JKrede/TPI-ED3/doc/img/DdB_ISR_Timer_2.pdf

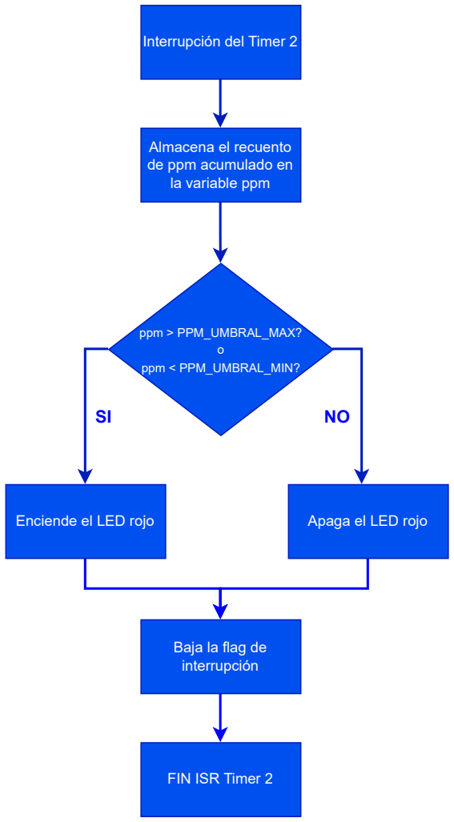
[picture p4: figure]
Interrupción del Timer 2; Almacena el recuento de ppm acumulado en la variable ppm; ppm > PPM_UMBRAL_MAX? o ppm < PPM_UMBRAL_MIN?; Enciende el LED rojo; Apaga el LED rojo; Baja la flag de interrupción; FIN ISR Timer 2
