JKrede/TPI-ED3/doc/img/DdB_Prog_princ.pdf

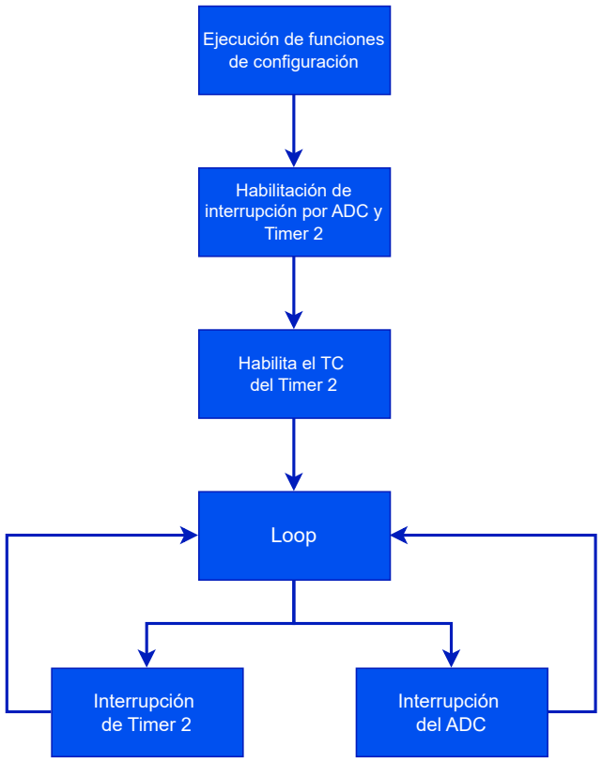
[picture p5: figure]
Ejecución de funciones de configuración; Habilitación de interrupción por ADC y Timer 2; Habilita el TC del Timer 2; Loop; Interrupción del ADC; Interrupción de Timer 2
