JKrede/TPI-ED3/doc/img/Diagrama-de-bloques.pdf

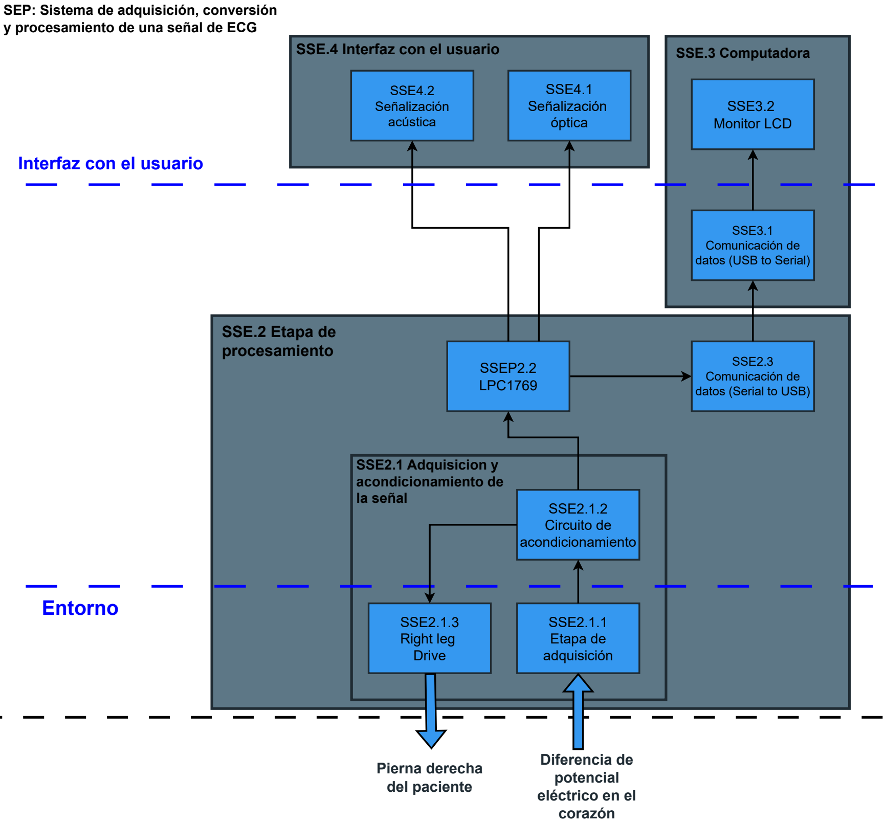
[picture p6: figure]
SSE.2 Etapa de procesamiento; SSE4.1 Señalización óptica; SSE4.2 Señalización acústica; SSE3.2 Monitor LCD; SSE2.3 Comunicación de datos (Serial to USB); SSEP2.2 LPC1769; SSE3.1 Comunicación de datos (USB to Serial); SSE.4 Interfaz con el usuario; SSE.3 Computadora; SEP: Sistema de adquisición, conversión y procesamiento de una señal de ECG; Interfaz con el usuario; Entorno; Diferencia de potencial eléctrico en el corazón; SSE2.1.2 Circuito de acondicionamiento; SSE2.1.1 Etapa de adquisición; SSE2.1 Adquisicion y acondicionamiento de la señal; SSE2.1.3 Right leg Drive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
