JKrede/TPI-ED3/doc/img/rld_diagram.png

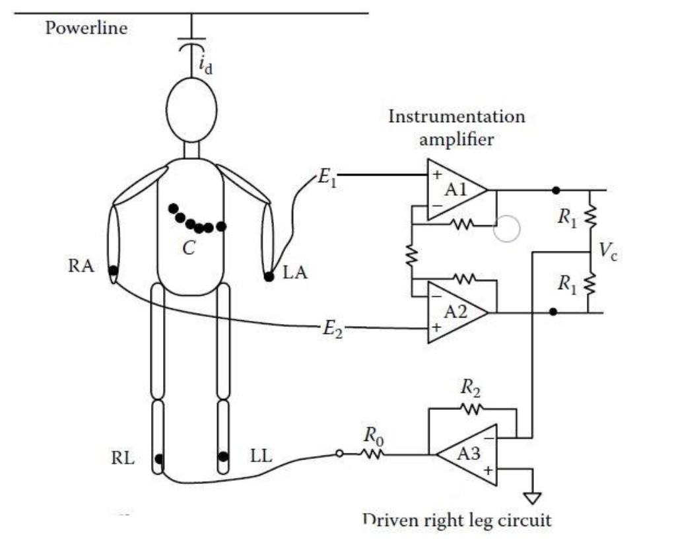
doc/img/rld_diagram.png
