JKrede/TPI-ED3/doc/casos_de_prueba.ods

Nro. de caso de prueba | Descripción del caso de prueba | Pasos | Resultado esperado | Resultado obtenido | Observaciones
1 | Envío de datos mediante el circuito de comunicación de datos
2 | Envío e interpretación correcta de los datos enviados en la aplicación desarrollada en la PC
3 | Activación del sistema de señalización óptica
4
5
4 | Activación del sistema de señalización acústica
