JKrede/TPI-ED3/doc/img/codigo_config.pdf

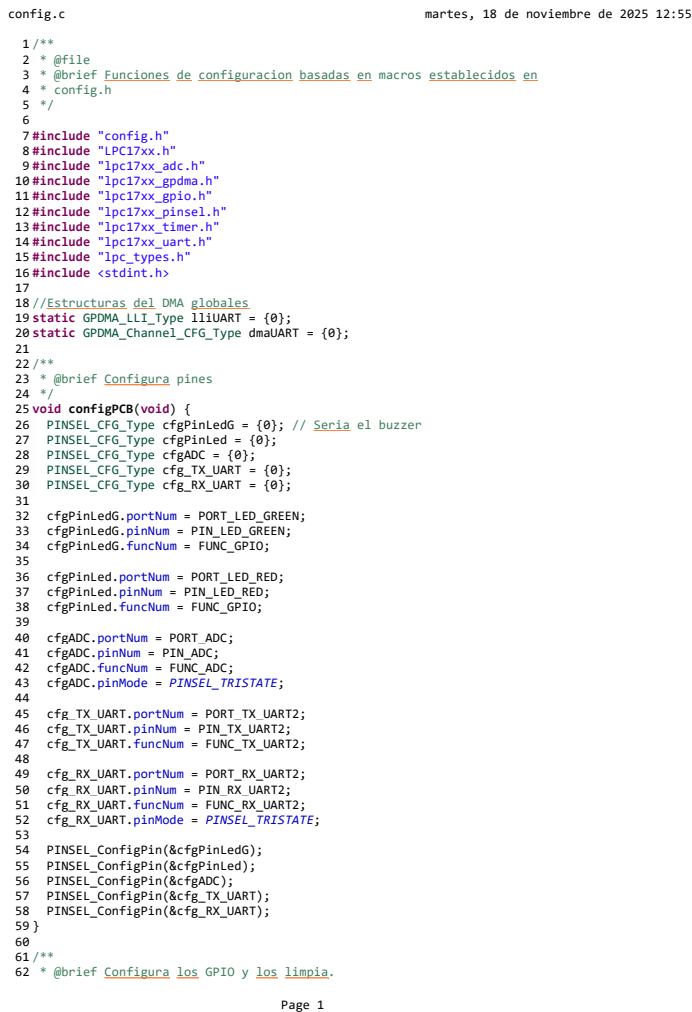
[picture p40: page 1]
config.c; martes, 18 de noviembre de 2025 12:55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

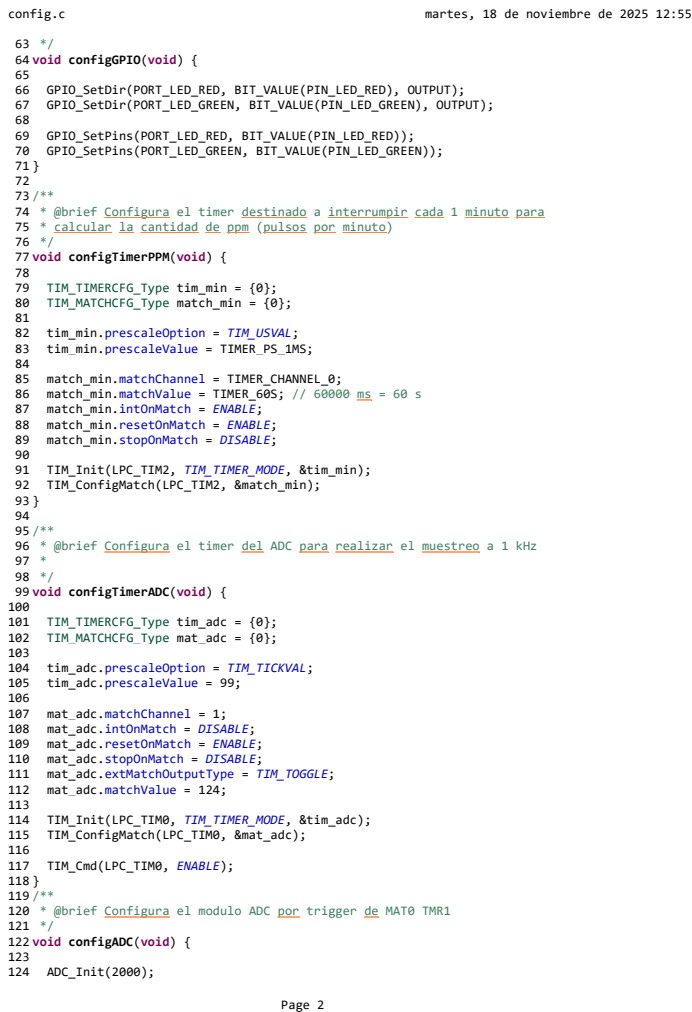
[picture p41: page 2]
config.c; martes, 18 de noviembre de 2025 12:55; 63 */ 64 void configGPIO(void) { 65 66 GPIO_SetDir(PORT_LED_RED, BIT_VALUE(PIN_LED_RED), OUTPUT); 67 GPIO_SetDir(PORT_LED_GREEN, BIT_VALUE(PIN_LED_GREEN), OUTPUT); 68 69 GPIO_SetPins(PORT_LED_RED, BIT_VALUE(PIN_LED_RED)); 70 GPIO_SetPins(PORT_LED_GREEN, BIT_VALUE(PIN_LED_GREEN))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

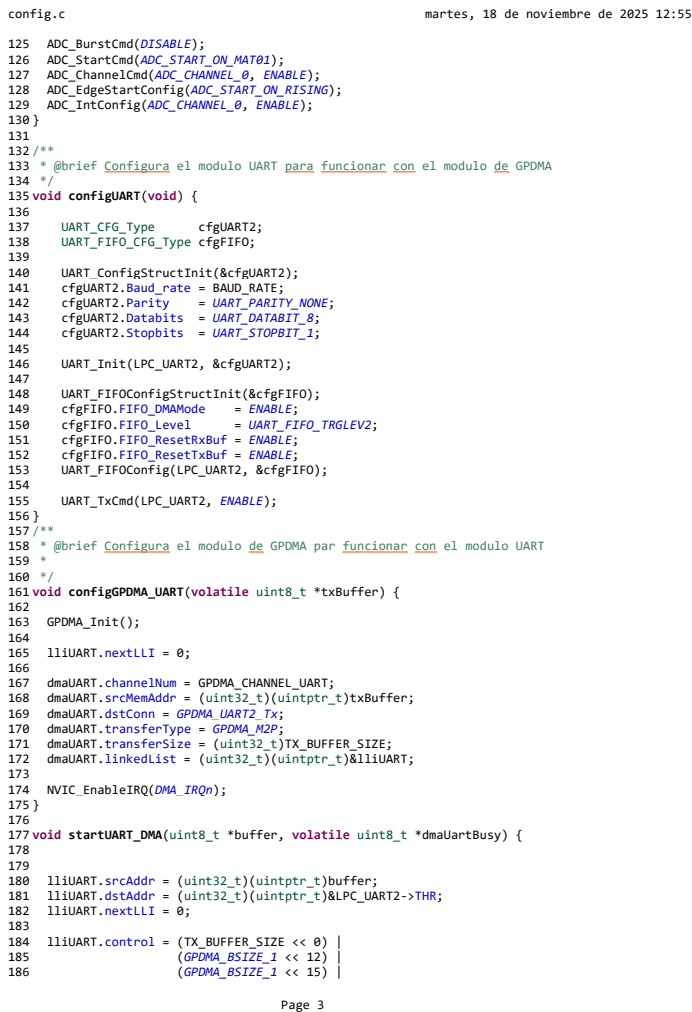
[picture p42: page 3]
config.c; martes, 18 de noviembre de 2025 12:55; 125 ADC_BurstCmd(DISABLE); 126 ADC_StartCmd(ADC_START_ON_MAT01); 127 ADC_ChannelCmd(ADC_CHANNEL_0, ENABLE); 128 ADC_EdgeStartConfig(ADC_START_ON_RISING); 129 ADC_IntConfig(ADC_CHANNEL_0, ENABLE); 130 } 131 132 /** 133 * @brief Configura el modulo UART para funcionar con el modulo de GPDMA 134 */ 135 void configUART(void) { 136; UART_CFG_Type; cfgUART2;; 138 UART_FIFO_CFG_Type cfgFIFO; 139 140 UART_ConfigStructInit(&cfgUART2)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

config.c | martes, 18 de noviembre de 2025 12:55

187 (GPDMA_BYTE << 18) |
188 (GPDMA_BYTE << 21) |
189 (1 << 26) |
190 (0 << 27) |
191 (1 << 31);
192
193 dmaUART.srcMemAddr = (uint32_t)(uintptr_t)buffer; 194 dmaUART.transferSize = (uint32_t)TX_BUFFER_SIZE; 195 dmaUART.linkedList = (uint32_t)(uintptr_t)&lliUART; 196
197 GPDMA_Setup(&dmaUART);
198 GPDMA_ChannelCmd(GPDMA_CHANNEL_UART, ENABLE);
199
200 *dmaUartBusy = 1;
201 }
202

Page 4
