JKrede/TPI-ED3/doc/img/codigo_main.pdf

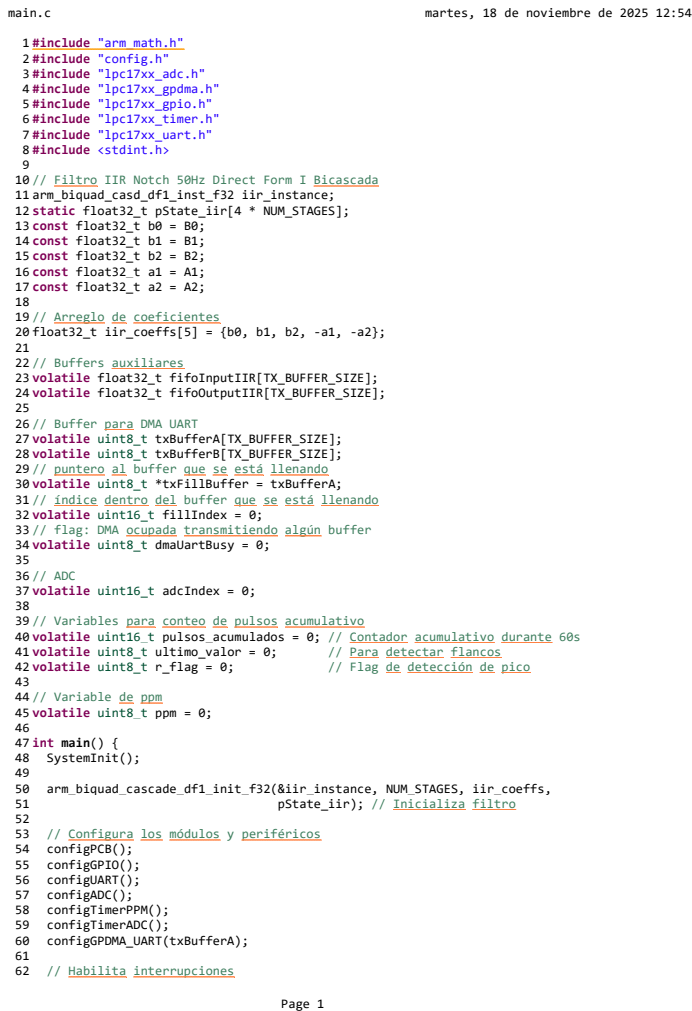
[picture p44: page 1]
main.c; martes, 18 de noviembre de 2025 12:54; 41 volatile uint8_t ultimo_valor = 0;; // Para detectar flancos; 42 volatile uint8_t r_flag = 0;; // Flag de detección de pico; Page 1

1 #include "arm_math.h"
2 #include "config.h"
3 #include "lpc17xx_adc.h"
4 #include "lpc17xx_gpdma.h"
5 #include "lpc17xx_gpio.h"
6 #include "lpc17xx_timer.h"
7 #include "lpc17xx_uart.h"
8 #include <stdint.h>
10 // Filtro IIR Notch 50Hz Direct Form I Bicascada
11 arm_biquad_casd_df1_inst_f32 iir_instance;
12 static float32_t pState_iir[4 * NUM_STAGES];
13 const float32_t b0 = B0;
14 const float32_t b1 = B1;
15 const float32_t b2 = B2;
16 const float32_t a1 = A1;
17 const float32_t a2 = A2;
19 // Arreglo de coeficientes
20 float32_t iir_coeffs[5] = {b0, b1, b2, -a1, -a2};
22 // Buffers auxiliares
23 volatile float32_t fifoInputIIR[TX_BUFFER_SIZE];
24 volatile float32_t fifoOutputIIR[TX_BUFFER_SIZE];
26 // Buffer para DMA UART
27 volatile uint8_t txBufferA[TX_BUFFER_SIZE];
28 volatile uint8_t txBufferB[TX_BUFFER_SIZE];
29 // puntero al buffer que se está llenando
30 volatile uint8_t *txFillBuffer = txBufferA;
31 // índice dentro del buffer que se está llenando
32 volatile uint16_t fillIndex = 0;
33 // flag: DMA ocupada transmitiendo algún buffer
34 volatile uint8_t dmaUartBusy = 0;
36 // ADC
37 volatile uint16_t adcIndex = 0;
39 // Variables para conteo de pulsos acumulativo
40 volatile uint16_t pulsos_acumulados = 0; // Contador acumulativo durante 60s
44 // Variable de ppm
45 volatile uint8_t ppm = 0;
47 int main() {
48 SystemInit();
50 arm_biquad_cascade_df1_init_f32(&iir_instance, NUM_STAGES, iir_coeffs,
51 pState_iir); // Inicializa filtro
53 // Configura los módulos y periféricos
54 configPCB();
55 configGPIO();
56 configUART();
57 configADC();
58 configTimerPPM();
59 configTimerADC();
60 configGPDMA_UART(txBufferA);
62 // Habilita interrupciones

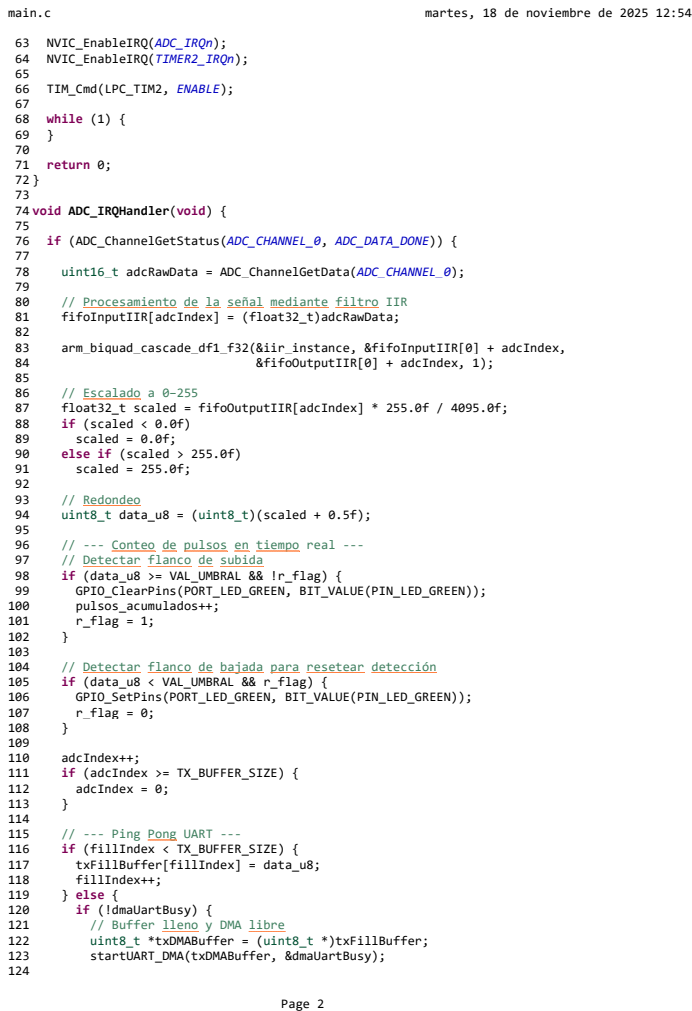
[picture p45: page 2]
main.c; martes, 18 de noviembre de 2025 12:54; 63 NVIC_EnableIRQ(ADC_IRQn); 64 NVIC_EnableIRQ(TIMER2_IRQn); 65 66 TIM_Cmd(LPC_TIM2, ENABLE); 67 68 while (1) { 69 } 70 71 return 0; 72 } 73 74 void ADC_IRQHandler(void) { 75 76 if (ADC_ChannelGetStatus(ADC_CHANNEL_0, ADC_DATA_DONE)) { 77 78 uint16_t adcRawData = ADC_ChannelGetData(ADC_CHANNEL_0); 79 80 // Procesamiento de la señal mediante filtro IIR 81 fifoInputIIR[adcIndex] = (float32_t)adcRawData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

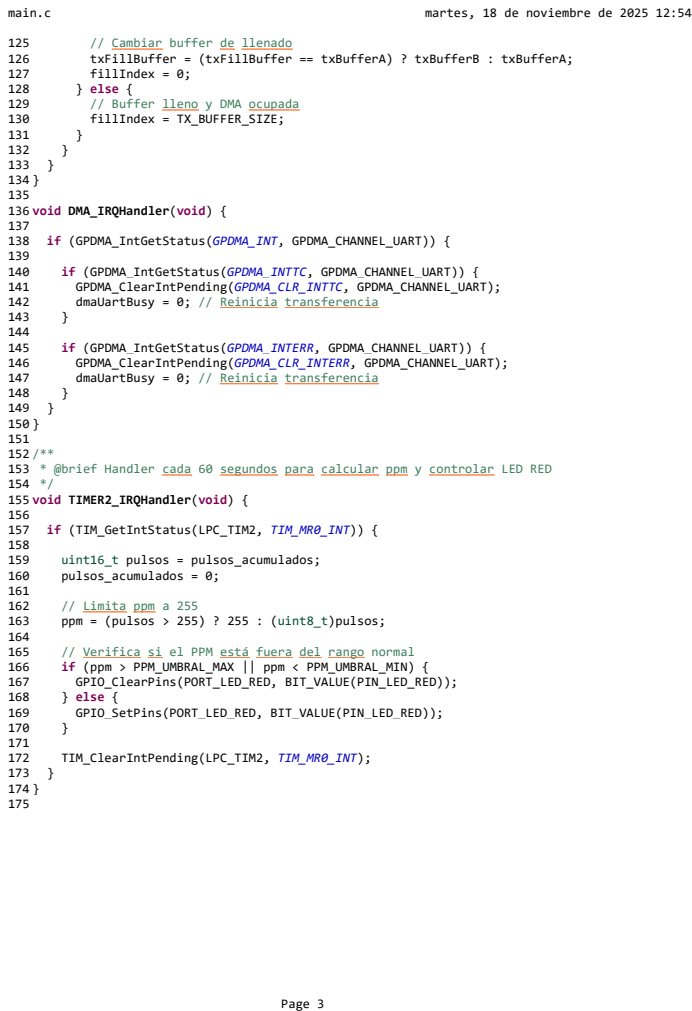
[picture p46: page 3]
main.c; martes, 18 de noviembre de 2025 12:54; 125 // Cambiar buffer de llenado 126 txFillBuffer = (txFillBuffer == txBufferA) ? txBufferB : txBufferA; 127 fillIndex = 0; 128 } else { 129 // Buffer lleno y DMA ocupada 130 fillIndex = TX_BUFFER_SIZE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
