JKrede/TPI-ED3/doc/img/DdB_ISR_ADC.pdf

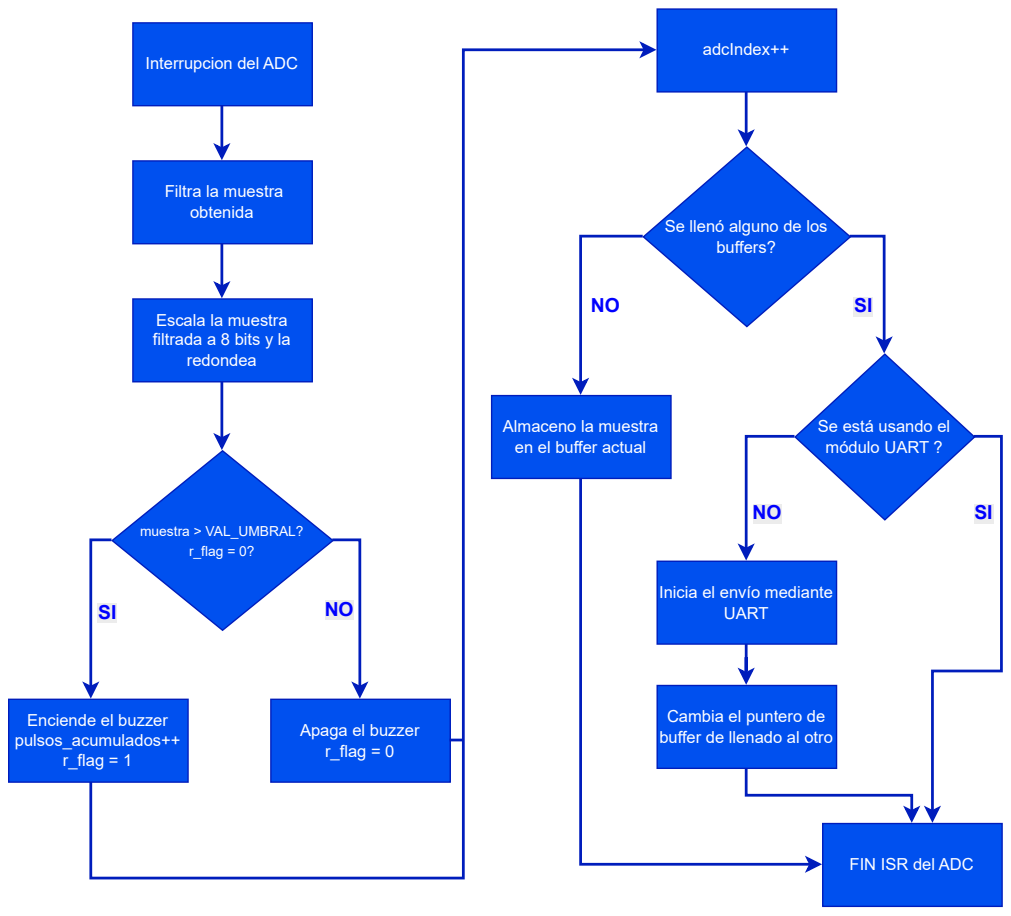
[picture p47: page 1]
muestra > VAL_UMBRAL? r_flag = 0?; Enciende el buzzer pulsos_acumulados++ r_flag = 1; adcIndex++; UART

Interrupcion del ADC

Filtra la muestra
obtenida

Se llenó alguno de los
buffers?

Escala la muestra
filtrada a 8 bits y la
redondea

Almaceno la muestra
en el buffer actual

Se está usando el
módulo UART ?

Inicia el envío mediante

Cambia el puntero de
buffer de llenado al otro

Apaga el buzzer
r_flag = 0

FIN ISR del ADC
