JKrede/TPI-ED3/dev/altium/ECGAquisitionBoard.pdf

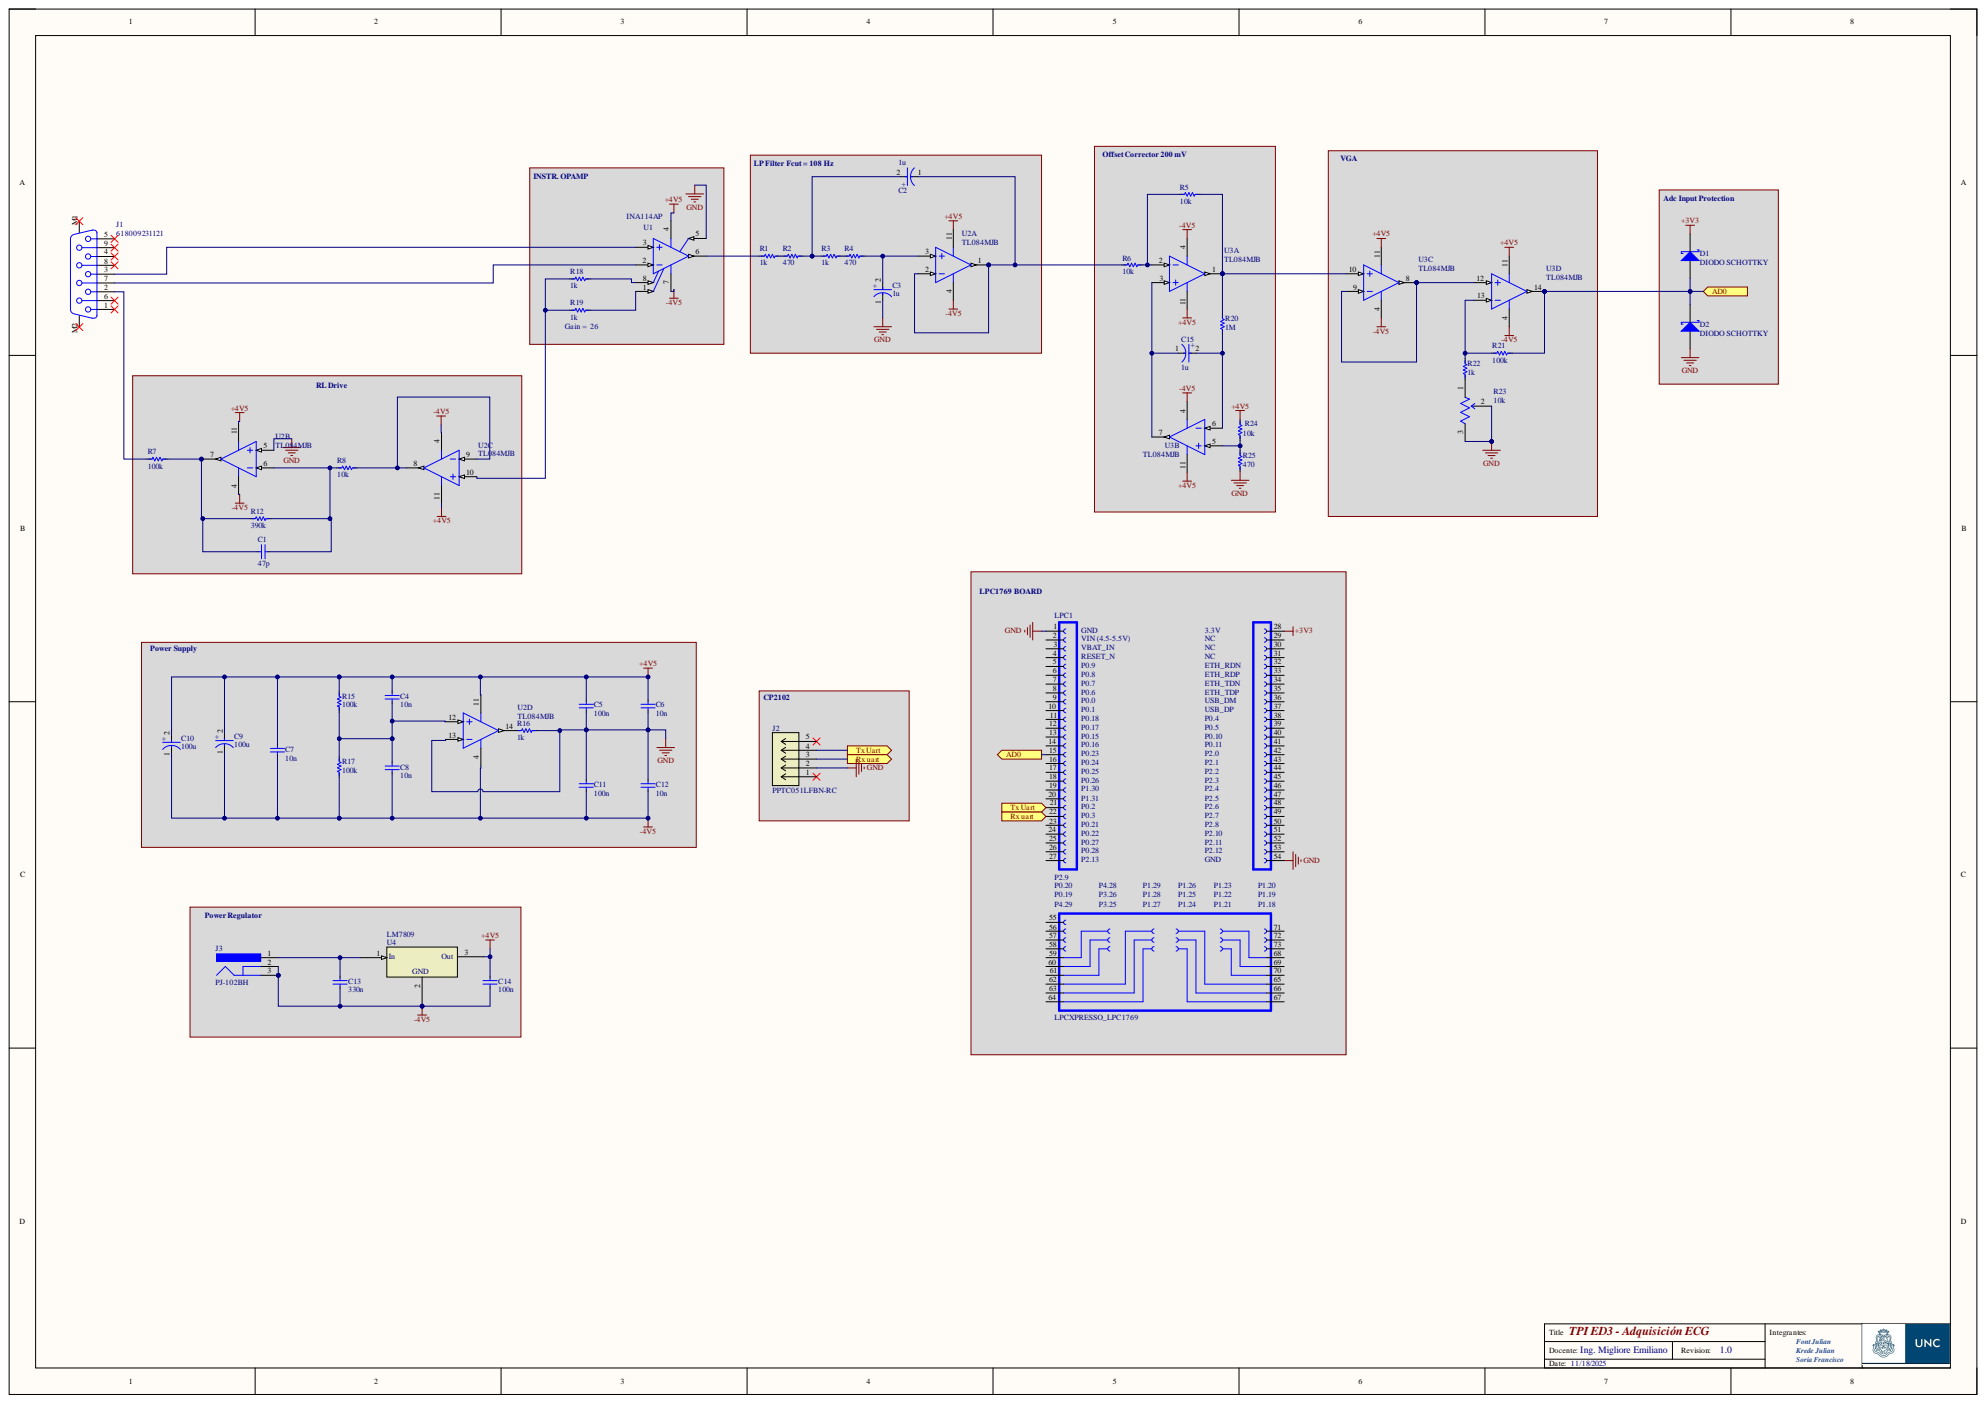
[picture p48: page 1]
