JKrede/TPI-ED3/(list of files, drawings)

Other design files:
dev/altium/_ECGAquisitionBoard.SchDoc
dev/altium/ECGAquisitionBoard.PcbDoc
dev/altium/ECGAquisitionBoard.PcbLib
dev/altium/ECGAquisitionBoard.PrjPcb
dev/altium/ECGAquisitionBoard.SchDoc
dev/altium/ECGAquisitionBoard.SchLib
