JKrede/TPI-ED3/dev/stm32/Core/Src/main.c

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
/* Includes ------------------------------------------------------------------*/
#include "main.h"

/* USER CODE BEGIN Includes */
#define FREQ_SAMPLING 1000
#define LED_VERDE GPIO_PIN_12
#define LED_NARANJA GPIO_PIN_13
#define LED_ROJO GPIO_PIN_14
#define LED_AZUL GPIO_PIN_15

#define ECG_30_SIZE (sizeof(ecg_30ppm)/sizeof(ecg_30ppm[0]))
#define ECG_60_SIZE (sizeof(ecg_60ppm)/sizeof(ecg_60ppm[0]))
#define ECG_120_SIZE (sizeof(ecg_120ppm)/sizeof(ecg_120ppm[0]))
#define ECG_180_SIZE (sizeof(ecg_180ppm)/sizeof(ecg_180ppm[0]))

volatile uint16_t i = 0;
volatile uint8_t n = 0;

const uint16_t ecg_30ppm[2000] = {
    189, 189, 189, 189, 189, 189, 189, 189, 189, 190,
    190, 190, 190, 190, 190, 190, 190, 190, 190, 190,
    190, 190, 190, 190, 190, 190, 190, 190, 190, 190,
    190, 190, 191, 191, 191, 191, 191, 191, 191, 191,
    191, 191, 191, 191, 191, 191, 191, 191, 191, 191,
    191, 191, 191, 191, 191, 191, 192, 192, 192, 192,
    192, 192, 192, 192, 192, 192, 192, 192, 192, 192,
    192, 192, 192, 192, 192, 192, 192, 192, 192, 192,
    193, 193, 193, 193, 193, 193, 193, 193, 193, 193,
    193, 193, 193, 193, 193, 193, 193, 193, 193, 193,
    193, 193, 193, 193, 194, 194, 194, 194, 194, 194,
    194, 194, 194, 194, 194, 194, 194, 194, 194, 194,
    194, 194, 194, 194, 194, 194, 194, 194, 194, 195,
    195, 195, 195, 195, 195, 195, 195, 195, 195, 195,
    195, 195, 195, 195, 195, 195, 195, 195, 195, 195,
    195, 195, 195, 195, 195, 196, 196, 196, 196, 196,
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
    248, 251, 254, 257, 260, 263, 267, 270, 274, 278,
    282, 286, 290, 294, 299, 303, 308, 313, 317, 322,
    326, 331, 335, 340, 344, 348, 353, 357, 361, 364,
    368, 372, 375, 378, 381, 384, 386, 388, 390, 392,
    393, 394, 395, 395, 395, 395, 394, 393, 392, 390,
    388, 386, 383, 380, 377, 374, 371, 367, 363, 359,
    355, 351, 347, 342, 338, 333, 328, 324, 319, 314,
    309, 305, 300, 296, 291, 287, 282, 278, 274, 270,
    267, 263, 260, 256, 253, 250, 247, 244, 242, 239,
    237, 235, 232, 231, 229, 227, 225, 224, 223, 221,
    220, 219, 218, 217, 217, 216, 215, 215, 214, 214,
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
};
/* USER CODE END Includes */

DAC_HandleTypeDef hdac;

TIM_HandleTypeDef htim2;

void SystemClock_Config(void);
static void MX_GPIO_Init(void);
static void MX_DAC_Init(void);
static void MX_TIM2_Init(void);
/**
  * @brief  The application entry point.
  * @retval int
  */
int main(void)
{

  /* MCU Configuration--------------------------------------------------------*/

  /* Reset of all peripherals, Initializes the Flash interface and the Systick. */
  HAL_Init();

  /* Configure the system clock */
  SystemClock_Config();

  /* Initialize all configured peripherals */
  MX_GPIO_Init();
  MX_DAC_Init();
  MX_TIM2_Init();
  /* USER CODE BEGIN 2 */
  HAL_DAC_Start(&hdac, DAC_CHANNEL_1);      // habilita DAC OUT1
  HAL_DAC_SetValue(&hdac, DAC_CHANNEL_1,    // valor inicial (evita 0V hasta la 1ª IRQ)
                   DAC_ALIGN_12B_R, ecg_60ppm[0]);
  HAL_TIM_Base_Start_IT(&htim2);            // TIM2 genera interrupción a 1 kHz

  /* USER CODE END 2 */

  /* Infinite loop */
  /* USER CODE BEGIN WHILE */
  while (1)
  {
    /* USER CODE END WHILE */

    /* USER CODE BEGIN 3 */
  }
  /* USER CODE END 3 */
}

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
/* USER CODE BEGIN 4 */


void HAL_TIM_PeriodElapsedCallback(TIM_HandleTypeDef *htim)
{
    if (htim->Instance == TIM2) {

		switch(n){
			case 0:	HAL_DAC_SetValue(&hdac, DAC_CHANNEL_1, DAC_ALIGN_12B_R, ecg_30ppm[i]);
					i = (i + 1)%ECG_30_SIZE;
					break;
			case 1:	HAL_DAC_SetValue(&hdac, DAC_CHANNEL_1, DAC_ALIGN_12B_R, ecg_60ppm[i]);
					i = (i + 1)%ECG_60_SIZE;
					break;
			case 2: HAL_DAC_SetValue(&hdac, DAC_CHANNEL_1, DAC_ALIGN_12B_R, ecg_120ppm[i]);
					i = (i + 1)%ECG_120_SIZE;
					break;
			case 3:	HAL_DAC_SetValue(&hdac, DAC_CHANNEL_1, DAC_ALIGN_12B_R, ecg_180ppm[i]);
					i = (i + 1)%ECG_180_SIZE;
					break;
		}
    }
}
void HAL_GPIO_EXTI_Callback(uint16_t GPIO_Pin){
    if (GPIO_Pin == GPIO_PIN_0)
    {
    	i = 0;
    	HAL_GPIO_WritePin(GPIOD, LED_ROJO, 0);
    	HAL_GPIO_WritePin(GPIOD, LED_VERDE, 0);
    	HAL_GPIO_WritePin(GPIOD, LED_NARANJA, 0);
    	HAL_GPIO_WritePin(GPIOD, LED_AZUL, 0);


    	n = (n + 1)%4;

    	switch(n){
    	case 0:	HAL_GPIO_WritePin(GPIOD, LED_ROJO, 1); break;
    	case 1:	HAL_GPIO_WritePin(GPIOD, LED_VERDE, 1); break;
    	case 2:	HAL_GPIO_WritePin(GPIOD, LED_NARANJA, 1); break;
    	case 3:	HAL_GPIO_WritePin(GPIOD, LED_AZUL, 1); break;

    	}
    }
}
/* USER CODE END 4 */
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
