JKrede/TPI-ED3/CMSISv2p00_LPC17xx/Drivers/inc/lpc17xx_pinsel.h

/**
 * @file        lpc17xx_pinsel.h
 * @brief       Contains all macro definitions and function prototypes
 *              support for Pin connect block firmware library on LPC17xx
 * @version     2.0
 * @date        21. May. 2010
 * @author      NXP MCU SW Application Team
 *
 * Software that is described herein is for illustrative purposes only
 * which provides customers with programming information regarding the
 * products. This software is supplied "AS IS" without any warranties.
 * NXP Semiconductors assumes no responsibility or liability for the
 * use of the software, conveys no license or title under any patent,
 * copyright, or mask work right to the product. NXP Semiconductors
 * reserves the right to make changes in the software without
 * notification. NXP Semiconductors also make no representation or
 * warranty that such application will be suitable for the specified
 * use without further testing or modification.
 *
 * @par Refactor:
 * Date: 07/07/2025, Author: David Trujillo Medina
 */

/* ---------------------------- Peripheral group ---------------------------- */
/** @defgroup PINSEL PINSEL
 * @ingroup LPC1700CMSIS_FwLib_Drivers
 * @{
 */

#ifndef LPC17XX_PINSEL_H_
#define LPC17XX_PINSEL_H_

/* -------------------------------- Includes -------------------------------- */
#include "lpc_types.h"
#include <LPC17xx.h>

#ifdef __cplusplus
extern "C" {
#endif

/* ----------------------------- Private Macros ----------------------------- */
/** @defgroup PINSEL_Private_Macros PINSEL Private Macros
 * @{
 */

/* ------------------------ MACROS MASKS DEFINITIONS ------------------------ */
#define PINSEL_FUNC_MASK ((0x3UL)) /**< Function selection mask. */
#define PINSEL_PIN_MASK ((0x1UL))  /** Pin selection mask. */

/* ------------------------- MACROS BIT DEFINITIONS ------------------------- */
#define PINSEL_TRACE_POS ((0x3UL)) /**< Trace pin position. */

/* Pin selection define */
/* I2C Pin Configuration register bit description */
#define PINSEL_I2CPADCFG_SDADRV0                                               \
  _BIT(0) /**< Drive mode control for the SDA0 pin, P0.27. */
#define PINSEL_I2CPADCFG_SDAI2C0                                               \
  _BIT(1) /**< I2C mode control for the SDA0 pin, P0.27. */
#define PINSEL_I2CPADCFG_SCLDRV0                                               \
  _BIT(2) /**< Drive mode control for the SCL0 pin, P0.28. */
#define PINSEL_I2CPADCFG_SCLI2C0                                               \
  _BIT(3) /**< I2C mode control for the SCL0 pin, P0.28. */

/**
 * @}
 */

/* ------------------------------ Public Types ------------------------------ */
/** @defgroup PINSEL_Public_Types PINSEL Public Types
 * @{
 */

/**
 * @brief Port selection for PINSEL.
 */
typedef enum {
  PINSEL_PORT_0 = 0,
  PINSEL_PORT_1,
  PINSEL_PORT_2,
  PINSEL_PORT_3,
  PINSEL_PORT_4
} PINSEL_PORT;
/** Check PINSEL port option parameter. */
#define PARAM_PINSEL_PORT(PORT)                                                \
  ((PORT) >= PINSEL_PORT_0 && (PORT) <= PINSEL_PORT_4)

/**
 * @brief Pin selection for PINSEL (0-31).
 */
typedef enum {
  PINSEL_PIN_0 = 0,
  PINSEL_PIN_1,
  PINSEL_PIN_2,
  PINSEL_PIN_3,
  PINSEL_PIN_4,
  PINSEL_PIN_5,
  PINSEL_PIN_6,
  PINSEL_PIN_7,
  PINSEL_PIN_8,
  PINSEL_PIN_9,
  PINSEL_PIN_10,
  PINSEL_PIN_11,
  PINSEL_PIN_12,
  PINSEL_PIN_13,
  PINSEL_PIN_14,
  PINSEL_PIN_15,
  PINSEL_PIN_16,
  PINSEL_PIN_17,
  PINSEL_PIN_18,
  PINSEL_PIN_19,
  PINSEL_PIN_20,
  PINSEL_PIN_21,
  PINSEL_PIN_22,
  PINSEL_PIN_23,
  PINSEL_PIN_24,
  PINSEL_PIN_25,
  PINSEL_PIN_26,
  PINSEL_PIN_27,
  PINSEL_PIN_28,
  PINSEL_PIN_29,
  PINSEL_PIN_30,
  PINSEL_PIN_31
} PINSEL_PIN;
/** Check PINSEL pin option parameter. */
#define PARAM_PINSEL_PIN(PIN) ((PIN) >= PINSEL_PIN_0 && (PIN) <= PINSEL_PIN_31)

/**
 * @brief Pin function selection for PINSEL.
 */
typedef enum {
  PINSEL_FUNC_0 = 0,
  PINSEL_FUNC_1,
  PINSEL_FUNC_2,
  PINSEL_FUNC_3
} PINSEL_FUNC;
/** Check PINSEL function option parameter. */
#define PARAM_PINSEL_FUNC(FUNC)                                                \
  ((FUNC) >= PINSEL_FUNC_0 && (FUNC) <= PINSEL_FUNC_3)

/**
 * @brief Pin mode selection for PINSEL.
 */
typedef enum {
  PINSEL_PULLUP = 0,
  PINSEL_REPEATER,
  PINSEL_TRISTATE,
  PINSEL_PULLDOWN
} PINSEL_PINMODE;
/** Check PINSEL pin mode option parameter. */
#define PARAM_PINSEL_PINMODE(MODE)                                             \
  ((MODE) >= PINSEL_PULLUP && (MODE) <= PINSEL_PULLDOWN)

/**
 * @brief Open drain mode selection for PINSEL.
 */
typedef enum { PINSEL_OD_NORMAL = 0, PINSEL_OD_OPENDRAIN } PINSEL_OD;
/** Check PINSEL open drain mode option parameter. */
#define PARAM_PINSEL_OD(OD)                                                    \
  ((OD) == PINSEL_OD_NORMAL || (OD) == PINSEL_OD_OPENDRAIN)

/**
 * @brief I2C drive mode selection for PINSEL.
 */
typedef enum { PINSEL_I2C_NORMAL = 0, PINSEL_I2C_FAST } PINSEL_I2C_MODE;
/** Check PINSEL I2C mode option parameter. */
#define PARAM_PINSEL_I2C_MODE(MODE)                                            \
  ((MODE) == PINSEL_I2C_NORMAL || (MODE) == PINSEL_I2C_FAST)

/**
 * @brief Pin configuration structure.
 */
typedef struct {
  PINSEL_PORT portNum;    /**< PINSEL_PORT_x [0...4]. */
  PINSEL_PIN pinNum;      /**< PINSEL_PIN_x [0...31]. */
  PINSEL_FUNC funcNum;    /**< PINSEL_FUNC_x [0...3]. */
  PINSEL_PINMODE pinMode; /**< Should be:
                          - PINSEL_PULLUP : Internal pull-up resistor.
                          - PINSEL_REPEATER : Repeater mode.
                          - PINSEL_TRISTATE : Tri-state.
                          - PINSEL_PULLDOWN : Internal pull-down resistor. */
  PINSEL_OD openDrain;    /**< Should be:
                          - PINSEL_OD_NORMAL : Pin is in the normal (not open
                          drain) mode.
                          - PINSEL_OD_OPENDRAIN : Pin is in the open drain mode. */
} PINSEL_CFG_Type;

/**
 * @}
 */

/* ---------------------------- Public Functions ---------------------------- */
/** @defgroup PINSEL_Public_Functions PINSEL Public Functions
 * @{
 */

/**
 * @brief       Configures the pin according to the parameters in pinCfg.
 *
 * @param[in]   pinCfg  Pointer to a PINSEL_CFG_Type structure that contains
 *                      the configuration information for the specified pin.
 */
void PINSEL_ConfigPin(const PINSEL_CFG_Type *pinCfg);

/**
 * @brief       Configures multiple pins according to the parameters in
 *              pinCfg and the pins mask.
 *
 * @param[in]   pinCfg  Pointer to a PINSEL_CFG_Type structure containing
 *                      the base configuration for the pins.
 * @param[in]   pins    32-bit value where each bit set to 1 indicates that
 *                      the corresponding pin (0-31) will be configured.
 *
 * @note        For each bit set in pins, the corresponding pin is configured
 *              using the parameters from pinCfg, except that the pinNum field
 * in the original pinCfg is ignored and set automatically for each pin.
 */
void PINSEL_ConfigMultiplePins(const PINSEL_CFG_Type *pinCfg, uint32_t pins);

/**
 * @brief       Configures the trace function.
 *
 * @param[in]   newState Must be:
 *                       - ENABLE : Enable Trace Function.
 *                       - DISABLE : Disable Trace Function.
 */
void PINSEL_ConfigTraceFunc(FunctionalState newState);

/**
 * @brief       Configures the I2C pins according to the specified parameters.
 *
 * @param[in]   driveMode Should be one of the following:
 *                        - PINSEL_I2C_NORMAL : Standard drive mode.
 *                        - PINSEL_I2C_FAST   : Fast Mode Plus drive mode.
 *
 * @param[in]   filterSlewRate Should be:
 *                             - ENABLE  : Enables filter and slew rate control.
 *                             - DISABLE : Disables filter and slew rate
 * control.
 *
 * @note        If filterSlewRate is DISABLE, the driveMode parameter
 *              is ignored and both pins are configured as standard drive mode
 *              (PINSEL_I2C_NORMAL) with filter and slew rate control disabled.
 */
void PINSEL_SetI2CPins(PINSEL_I2C_MODE driveMode,
                       FunctionalState filterSlewRate);

/**
 * @}
 */

#ifdef __cplusplus
}
#endif

#endif // LPC17XX_PINSEL_H_

/**
 * @}
 */

/* ------------------------------ End Of File ------------------------------- */
