JKrede/TPI-ED3/(commit log)

2025-10-20 Correccion para usar cmake
2025-10-20 Agregado de cmake para configuracion
2025-10-20 Agregado los drivers de LPC17xx (los de david)
2025-10-23 Correccion de gitignore para permitir pdf
2025-10-23 Agrego esquematico Altium e informe de soporte
    [ECGAquisitionBoard.SchDoc]
2025-10-30 add stm32f407 files
2025-10-30 update Altium files
    [ECGAquisitionBoard.PcbDoc, ECGAquisitionBoard.PrjPcb, ECGAquisitionBoard.SchDoc, _ECGAquisitionBoard.SchDoc]
2025-10-31 Agrega anteproyecto de informe
2025-10-31 Agrego librerias Altium
    [ECGAquisitionBoard.PcbDoc, ECGAquisitionBoard.PcbLib, ECGAquisitionBoard.PrjPcb, ECGAquisitionBoard.SchDoc, ECGAquisitionBoard.SchLib]
2025-10-31 Quito .dll de gitignore
2025-10-31 Agrega el directorio inc dentro de los includepaths del proyecto
2025-11-01 Desarrollo la PCB
    [ECGAquisitionBoard.PcbDoc, ECGAquisitionBoard.PcbLib, ECGAquisitionBoard.PrjPcb, ECGAquisitionBoard.SchDoc, ECGAquisitionBoard.SchLib]
2025-11-01 Agrega el directorio CMSISv2p00_LPC17xx/inc dentro de los includepaths del proyecto
2025-11-01 Corrige mala inclusion de LPC17xx.h
    [lpc17xx_pinsel.h]
2025-11-02 Termino segunda version del Altium
    [ECGAquisitionBoard.PcbDoc, ECGAquisitionBoard.PcbLib, ECGAquisitionBoard.SchDoc, ECGAquisitionBoard.SchLib]
2025-11-03 Actualizo la PCB v3.0
    [ECGAquisitionBoard.PcbDoc, ECGAquisitionBoard.PcbLib, ECGAquisitionBoard.SchDoc, ECGAquisitionBoard.SchLib]
2025-11-03 Actualizo circuito
    [ECGAquisitionBoard.PcbDoc, ECGAquisitionBoard.SchDoc]
2025-11-06 Corrige el tipo del puntero a LPC_UART0
    [LPC17xx.h]
2025-11-06 Agrega archivos de configuracion del proyecto
2025-11-06 Separa la configuracion de DMA para cada modulo
2025-11-08 Reorganiza los archivos de simulacion de ecg
2025-11-08 Reorganiza archivos de simulacion de ecg
2025-11-14 Solo cambia el tamaño de la PCB de 10x10 a 10x15
2025-11-15 Agrega reorganiacion PCB 10x15
2025-11-16 Agrega test para buffer y para deteccion de umbral por ADC
2025-11-17 Agrega dma cambios finales
2025-11-17 Agrega logica de buzzer y led
    [config.c, config.h, main.c]
2025-11-18 Corrige configuracion de timers
    [config.c]
2025-11-18 Modifica el sistema para que el buzzer sea un led
    Cambia el buzzer para que sea una luz de la placa
    [config.c, config.h, main.c]
2025-11-18 Arregla el problema de versiones. Estable
    [config.c, config.h, main.c]
2025-11-18 Version final - God
    [ECGAquisitionBoard.SchDoc]
2025-11-18 Agrega el excel de casos de prueba
    [casos_de_prueba.ods]
2025-11-18 Optimizacion de codigo en main
2025-11-18 Agrega los diagramas de bloque
