JKrede/TPI-ED3/(notices)

Notices in the files:
dev/stm32/Core/Src/main.c:
Copyright (c) 2025 STMicroelectronics.
All rights reserved.
This software is licensed under terms that can be found in the LICENSE file
